TechHU-GS/tt10-tinyQV/test/tb_read_clear_regression.v

// ============================================================================
// Regression Test: TinyQV bit-serial read + read-to-clear registers
// ============================================================================
// Bug: TinyQV is a 4-bit serial CPU. A 32-bit MMIO read takes 8 clock
// cycles with read_n active throughout. If a peripheral clears a flag on
// the first cycle of read_n (data_rd = read_n != 2'b11), status bits in
// upper nibbles read as stale/zero by the time the CPU shifts them in.
//
// Fix: read-side-effects must use read_complete (1-cycle pulse at END),
// not the multi-cycle data_rd derived from read_n.
//
// This test verifies:
//   1. I2C: RX_VALID (bit[10]) remains stable during 8-cycle read
//   2. I2C: rx_has_data clears only AFTER read_complete fires
//   3. Seal: read_seq advances only on read_complete, not on multi-cycle read
//   4. Seal: data_out remains stable during 8-cycle read
// ============================================================================
`timescale 1ns/1ps

module tb_read_clear_regression;
    reg         clk;
    reg         rst_n;

    integer pass_count = 0;
    integer fail_count = 0;
    integer total_tests = 0;

    task check(input [255:0] name, input condition);
    begin
        total_tests = total_tests + 1;
        if (condition) begin
            pass_count = pass_count + 1;
            $display("[PASS] %0s", name);
        end else begin
            fail_count = fail_count + 1;
            $display("[FAIL] %0s", name);
        end
    end
    endtask

    // Clock: 25MHz = 40ns period
    initial clk = 0;
    always #20 clk = ~clk;

    // ====================================================================
    // Part 1: I2C Peripheral — RX_VALID stability during multi-cycle read
    // ====================================================================
    reg  [31:0] i2c_data_in;
    reg         i2c_data_wr;
    reg         i2c_data_rd;     // single-cycle pulse (read_complete)
    wire [31:0] i2c_data_out;
    reg  [31:0] i2c_config_in;
    reg         i2c_config_wr;
    wire [31:0] i2c_config_out;

    // I2C bus: stub (loopback not needed for this test)
    wire scl_o, scl_t, sda_o, sda_t;

    i2c_peripheral i_i2c (
        .clk(clk), .rst_n(rst_n),
        .data_in(i2c_data_in), .data_wr(i2c_data_wr),
        .data_rd(i2c_data_rd), .data_out(i2c_data_out),
        .config_in(i2c_config_in), .config_wr(i2c_config_wr),
        .config_out(i2c_config_out),
        .scl_i(scl_t), .scl_o(scl_o), .scl_t(scl_t),
        .sda_i(sda_t), .sda_o(sda_o), .sda_t(sda_t)
    );

    // ====================================================================
    // Part 2: Seal Register — read_seq stability during multi-cycle read
    // ====================================================================
    reg         seal_data_wr;
    reg  [31:0] seal_data_in;
    wire [31:0] seal_data_out;
    reg         seal_data_rd;    // single-cycle pulse (read_complete)
    reg         seal_ctrl_wr;
    reg  [9:0]  seal_ctrl_in;
    wire [31:0] seal_ctrl_out;

    wire [7:0]  seal_crc_byte;
    wire        seal_crc_feed;
    wire        seal_crc_init;
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
